TanoZhang/AI-accelerators/verification/results/feeder_comparison.csv

case | M | N | K | scalar_total_cycles | parallel_total_cycles | total_speedup | scalar_compute_cycles | parallel_compute_cycles | compute_speedup | scalar_dma_cycles | parallel_dma_cycles
signed_min_1x1_int32 | 1 | 1 | 1 | 50 | 44 | 1.136364 | 15 | 9 | 1.666667 | 11 | 11
basic_2x2_int32 | 2 | 2 | 2 | 104 | 90 | 1.155556 | 24 | 10 | 2.400000 | 56 | 56
fpga_ab_8x8x8_int32 | 8 | 8 | 8 | 1037 | 795 | 1.304403 | 309 | 67 | 4.611940 | 704 | 704
edge_5x3x7_int32 | 5 | 3 | 7 | 546 | 441 | 1.238095 | 137 | 32 | 4.281250 | 385 | 385
edge_3x5x5_quant_shift2 | 3 | 5 | 5 | 375 | 304 | 1.233553 | 101 | 30 | 3.366667 | 250 | 250
positive_saturation | 4 | 4 | 8 | 374 | 312 | 1.198718 | 78 | 16 | 4.875000 | 272 | 272
negative_saturation | 4 | 4 | 8 | 454 | 392 | 1.158163 | 78 | 16 | 4.875000 | 352 | 352
edge_7x6x3_quant_relu | 7 | 6 | 3 | 642 | 575 | 1.116522 | 129 | 62 | 2.080645 | 489 | 489
relu_2x3x4_int32 | 2 | 3 | 4 | 182 | 152 | 1.197368 | 42 | 12 | 3.500000 | 116 | 116
edge_6x5x7_int32 | 6 | 5 | 7 | 678 | 471 | 1.439490 | 273 | 66 | 4.136364 | 381 | 381
backpressured_5x5x5_quant | 5 | 5 | 5 | 875 | 738 | 1.185637 | 201 | 64 | 3.140625 | 650 | 650
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
