TanoZhang/AI-accelerators/verification/results/figures/rtl-waveform-backpressured-5x5.csv

signal | absolute_time_ps | time_from_start_ns | value
accel_busy | 40810000 | 0.000 | 0
accel_busy | 40845000 | 35.000 | 1
accel_busy | 48205000 | 7395.000 | 0
dma_busy | 40810000 | 0.000 | 0
dma_busy | 40855000 | 45.000 | 1
dma_busy | 42855000 | 2045.000 | 0
dma_busy | 42875000 | 2065.000 | 1
dma_busy | 44875000 | 4065.000 | 0
dma_busy | 45695000 | 4885.000 | 1
dma_busy | 48195000 | 7385.000 | 0
compute_busy | 40810000 | 0.000 | 0
compute_busy | 44895000 | 4085.000 | 1
compute_busy | 45535000 | 4725.000 | 0
mac_en | 40810000 | 0.000 | 0
mac_en | 44935000 | 4125.000 | 1
mac_en | 44985000 | 4175.000 | 0
mac_en | 45055000 | 4245.000 | 1
mac_en | 45105000 | 4295.000 | 0
mac_en | 45225000 | 4415.000 | 1
mac_en | 45275000 | 4465.000 | 0
mac_en | 45395000 | 4585.000 | 1
mac_en | 45445000 | 4635.000 | 0
output_writer_busy | 40810000 | 0.000 | 0
output_writer_busy | 45005000 | 4195.000 | 1
output_writer_busy | 45165000 | 4355.000 | 0
output_writer_busy | 45175000 | 4365.000 | 1
output_writer_busy | 45335000 | 4525.000 | 0
output_writer_busy | 45345000 | 4535.000 | 1
output_writer_busy | 45505000 | 4695.000 | 0
output_writer_busy | 45515000 | 4705.000 | 1
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
