TanoZhang/AI-accelerators/verification/results/figures/performance-benchmark-summary.png

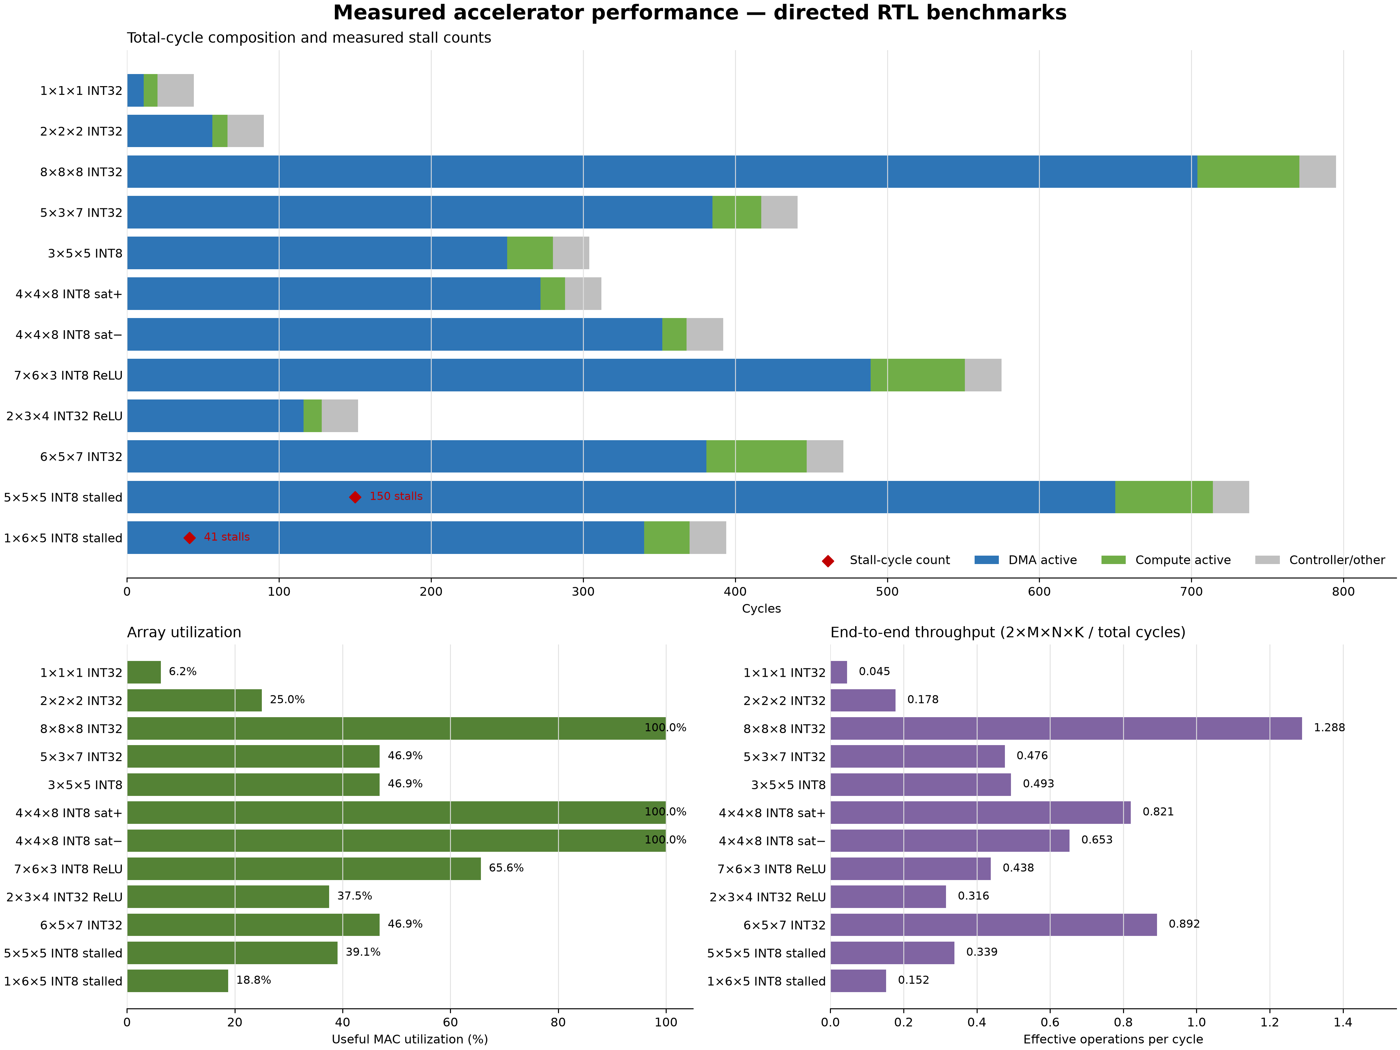
verification/results/figures/performance-benchmark-summary.png
