TanoZhang/AI-accelerators/verification/results/figures/rtl-waveform-backpressured-5x5.png

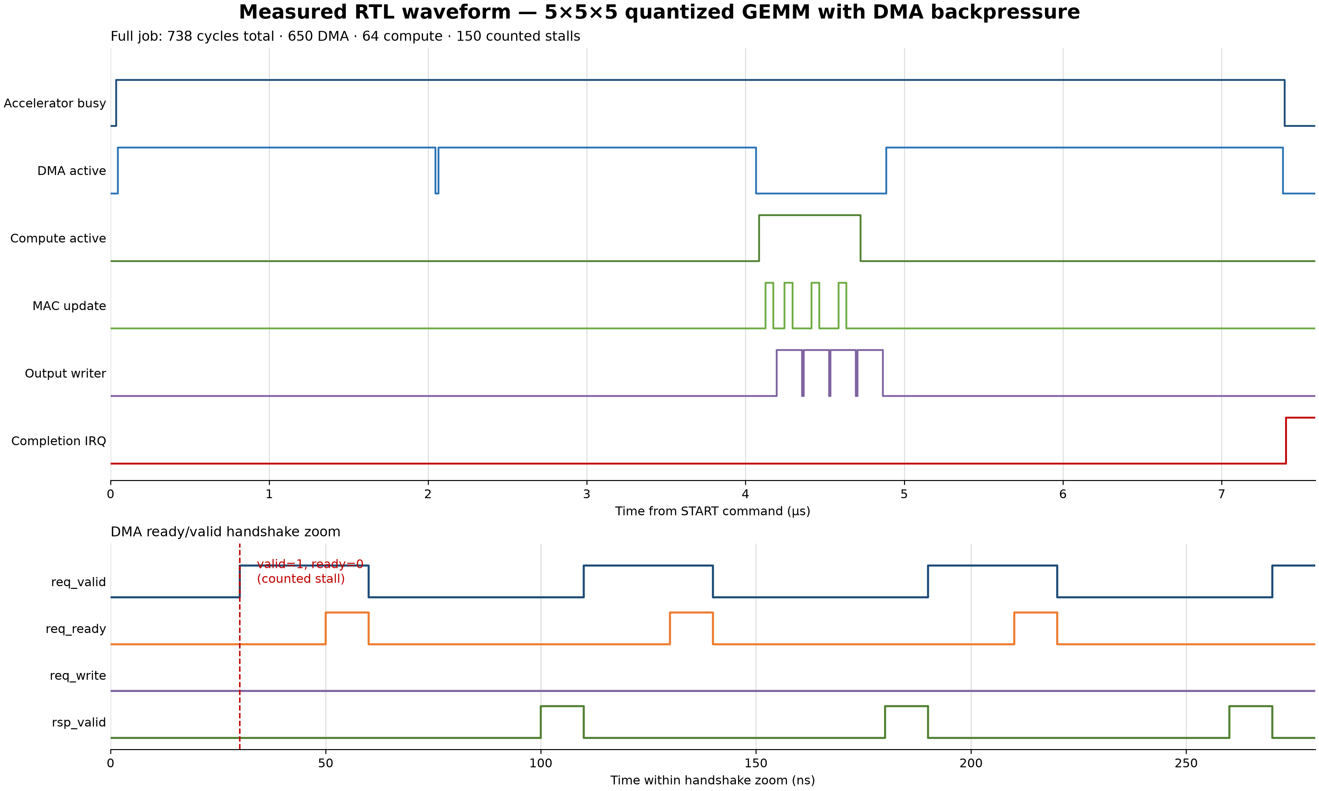
verification/results/figures/rtl-waveform-backpressured-5x5.png
