TanoZhang/AI-accelerators/(commit log)

2026-08-31 Add RTL accelerator and DE25-Standard validation
    [error_scenarios.csv, performance.csv, rtl-waveform-backpressured-5x5.csv]
2026-08-31 Add scalar and parallel feeder benchmark
    [feeder_comparison.csv, performance.csv, rtl-waveform-backpressured-5x5.csv]
